Utedass/Tangentbordsknappar/electronics/design description/main.tex

\documentclass[11px]{specification}

% Input encoding and typographical rules for English language
\usepackage[utf8]{inputenc}
\usepackage[english]{babel}
\usepackage[english]{isodate}

\usepackage{float}

\usepackage{lipsum}
\usepackage{amsmath}

\usepackage{fontspec}
\usepackage{newunicodechar}
\newfontfamily\symbola{Symbola}
\newcommand{\downzigzagarrow}{\begingroup\symbola ↯\endgroup}
\newunicodechar{↯}{\downzigzagarrow}

% These define global texts that are used in headers and titles.
\title{BBB, Bestest Button Brick \\- Design Description}
\author{Jonatan Gezelius}
\date{Februari 2026}
\revision{Revision 0.1}
\companylogo{↯ Jegatron Electronics ↯}

\begin{document}

\maketitle

\section{Background}

\begin{multicols}{2}

\begin{colblock}
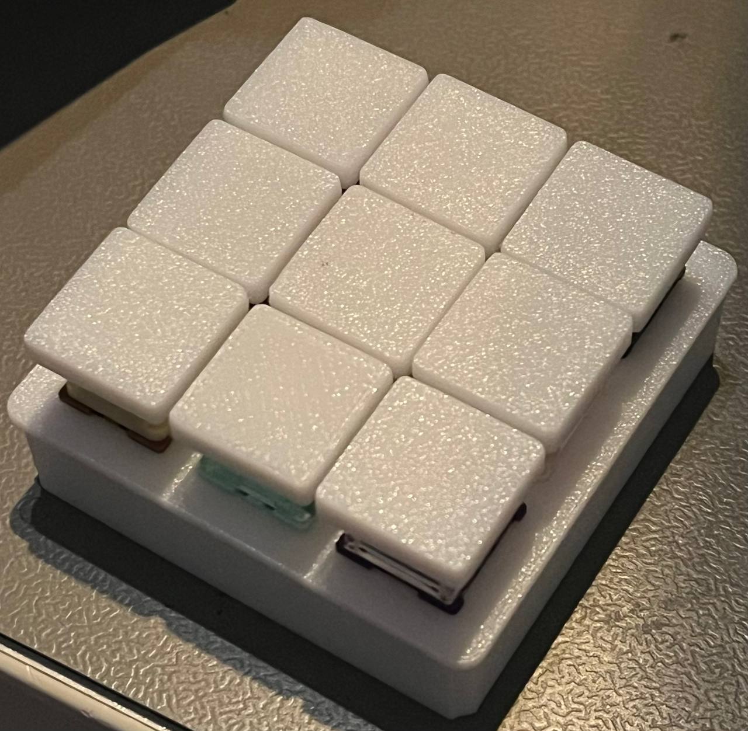
[picture p1: electronics/design description/figures/BBB-photo.jpg]
    
    \captionof{figure}{First iteration of BBB}
    \label{fig:systemDiagram}
\end{colblock}

The BBB is a multipurpose user programmable input device and also serves as an exercise product to hone my skills and try out different circuit solutions. Not all features and component make sense from a real product perspective, but serves as a learning experience.

It all started with the desire to have a more professional feel to my hobby and learning projects. So instead of using the classical tactile buttons forced down into a breadboard entangled in jumper wires, I bought some random mechanical keyboard switches and 3d-printed an enclosure for them. Then came the time to make the circuit board to empower this.

Feature creep. That is the spirit of this project. Because of personal projects I need the BBB need to be Zigbee enabled and preferably also wifi capable. Since I had already used the ESP32-C6 for such purposes I decided to use this.

\section{Features}

\begin{itemize}
    \item{Nine user programmable buttons}
    \item{ESP32-C6 - Zigbee, Wifi, BLE etc}
    \item{LiPo charger with Power Path}
    \item{USB-C sink IC}
    \item{LED lights}
\end{itemize}

\newpage
\tableofcontents

\newpage

\section{This document}
This document serves several purposes.
\begin{itemize}
    \item Description document when the design is done
    \item Working out the design
    \item Pointing out important design decisions
    \item Pointing out non-important design decisions
    \item Recognizing requirements
\end{itemize}

Design problems and decisions are written in a rounded rectangle.
\decision{How should I describe the design problems to the reader?}[By example!]

And recognized requirements are written in a sharp cornered rectangle.
\requirement*{The Design Description shall explain the usage of requirements in the document.}

These are summarized in the end of the document with the intent of being an input for external requirement management.

\newpage

\section{Hardware design}

The hardware architecture can be seen in figure \ref{fig:system-overview}. The design can definitely be made more simple and cheap, but that is not the purpose of this project. However, several of the parts can be skipped if not desired.

\subsection{Desired features}

\begin{itemize}
    \item{Zigbee}
    \item{Wifi}
    \item{Battery powered long life}
    \item{USB-C powered / charged}
    \item{LED lights}
\end{itemize}

\subsection{Optional Subsystems}

The following parts can be not-mounted or replaced with something else:
\begin{itemize}
    \item{USB-C Sink controller: Can be replaced by resistors.}
    \item{Fuel Gauge: Can be removed and the battery power can be bridged directly to the charger}
    \item{LiPo Charger + LiPo battery: Can be removed. System power directly bridged from VBUS.}
    \item{Boost regulator + LED Matrix: Can be skipped}
    \item{Miniature speaker: Can be skipped}
    \item{Flash: Can be avoided if using ESP32-C6FH4 or ESP32-C6FH8 instead}
\end{itemize}

\end{multicols}

\begin{figure}[H]
    \centering
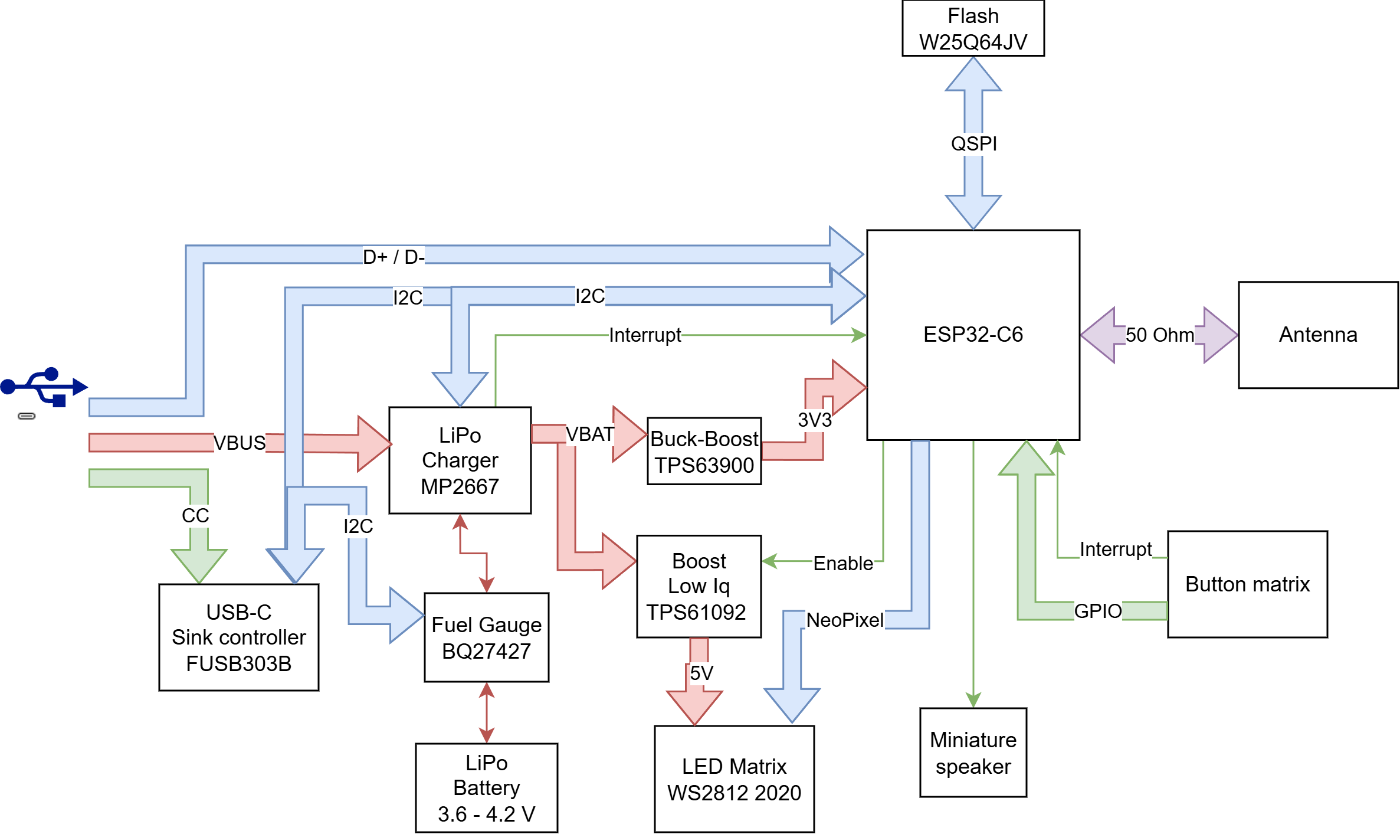
[picture p2: electronics/design description/figures/system-diagram.png]
    
    \caption{The hardware architecture of the BBB}
    \label{fig:system-overview}
\end{figure}

\newpage

\begin{multicols}{2}

\subsection{Power requirements}

Before any parts of the circuit can be properly designed, we need to determine the power and current requirements throughout the system.

The maximum peak current consumption of the ESP32-C6 is during WiFi transmission, which can be up to \qty{354}{\milli\ampere} at \qty{3.3}{\volt} which is about \qty{1.2}{\watt} \cite[66]{esp32-c6-datasheet}. The average power consumption will be much lower than this, but we need to design the power system to be able to handle this peak.

Each WS2812 2020 LED consumes about $3 \times \qty{12}{\milli\ampere} \approx \qty{40}{\milli\ampere}$ at full brightness. Which for the full matrix of 9 LEDs would be about \qty{360}{\milli\ampere}, which at \qty{5}{\volt} would be \qty{1.8}{\watt} \cite{ws2812-product-page}.

A speaker such as \url{https://www.electrokit.com/en/miniatyrhogtalare-8ohm-1w-11x15mm} driven with a MAX98357A class D amplifier can consume up to \qty{1}{\watt} at \qty{5}{\volt}, which is about \qty{200}{\milli\ampere}. It is possible to run it directly from $V_{SYS}$ from the battery but it cannot output the full power. And since the \qty{5}{\volt} boost regulator will be able to handle \qty{1.5}{\ampere} when fed with \qty{3.6}{\volt} from the battery I decide to put it on the \qty{5}{\volt} rail.

\end{multicols}

\begin{table}[H]
    \centering
    \begin{tabular}{|l|r|r|r|}
        \hline
        \textbf{Subsystem}     & \textbf{Voltage} & \textbf{Peak Current}    & \textbf{Peak Power}       \\
        \hline
        ESP32-C6 (WiFi TX)     & \qty{3.3}{\volt} & \qty{354}{\milli\ampere} & \qty{1.2}{\watt}          \\
        LED Matrix (9x WS2812) & \qty{5}{\volt}   & \qty{360}{\milli\ampere} & \qty{1.8}{\watt}          \\
        Speaker (MAX98357A)    & \qty{5}{\volt}   & \qty{200}{\milli\ampere} & \qty{1.0}{\watt}          \\
        \hline
        \textbf{Total}         &                  &                          & \textbf{\qty{4.0}{\watt}} \\
        \hline
    \end{tabular}
    \caption{Peak current and power consumption summary}
    \label{tab:power-summary}
\end{table}

\begin{multicols}{2}

A \qty{500}{\mAh} battery might fit into the enclosure, and with an allowed discharge current of \qty{2}{C} it will only be able to provide max \qty{3.6}{\watt}. So not all things will be able to run at full power at the same time, but that is not a requirement for this project.

\subsection{Battery}
The thickness of the current compartment left for a battery is at most \qty{5}{\milli\meter}. The area depends on wether the PCB will be fastened by screws or not. If screws are used, then only a maximum of \qtyproduct{35 x 35}{\milli\meter} is available for a battery.

\decision{What battery to use?}[Go with the \qty{400}{mAh} battery from electrokit for now: \url{https://www.electrokit.com/batteri-lipo-3.7v-400mah}]

I should probably redesign the enclosure to allow for a bigger battery. It might be difficult to fit this with connectors and all.

\begin{table}[H]
    \centering
    \begin{tabular}{|l|r|}
        \hline
        \textbf{Property}            & \textbf{Value}           \\
        \hline
        Recommended Charging Current & \qty{80}{\milli\ampere}  \\
        Maximum Charging Current     & \qty{400}{\milli\ampere} \\
        Maximum Discharge Current    & \qty{800}{\milli\ampere} \\
        \hline
    \end{tabular}
    \caption{Battery specifications}
    \label{tab:battery-specs}
\end{table}

\subsection{Charger Circuit}
BQ25601

Other candidates were MP2667, which has better quiescent current but no OTG and BQ25895 but it has D+/D- pins which I require for other purposes.
\requirement{The battery charger shall be optional}

\decision{Should I make use of the shipping mode for the battery?}

\subsubsection{Important features}
As soon as the input voltage or battery voltage is high enough, the device will power up. At power up, the Input Current Limit is updated to reflect the \sig{PSEL} pin (\qty{500}{\milli\ampere} or \qty{2.4}{\ampere}). When this is done, the system output \sig{} is soft-started and the switch converter for the battery charging is enabled.

If nothing is done, the device will automatically enter Default Mode which means it will autonomously act as a battery charger and charge the battery. To exit this mode, the host must write a 1 to the \sig{WD\_RST} but. Then the device enters Host Mode until the watchdog timer times out and \sig{WATCHDOG\_FAULT} is set and the device returns to Default Mode.

The default fast charging current \sig{ICHG} is \qty{2040}{\milli\ampere} which is way too much for the chosen battery. Setting the Input Current Limit \sig{IINDPM} using the pin \sig{PSEL} high limits this to \qty{500}{\milli\ampere}. This might still be too much since the proposed battery allows a maximum charging current of \qty{400}{\milli\ampere} and the step-down converter will allow a higher charging current than input current.

\decision{Will the charger have to be disabled somehow at startup, and later enabled by the host, to prevent over current to the battery? Can be handled via the $\bar{CE}$ pin.}[Yes, the current is way too large for this battery, the $\bar{CE}$ pin must be pulled up to prevent automatic charging.]

\decision{Will some sort of startup delay or under-voltage-lock-out be needed for the subsequent circuits so that the soft-start can work properly?}

The device can operate in boost-mode to convert the battery voltage to \qty{5}{\volt} and max \qty{1.2}{\ampere} for OTG use. This is controlled via I2C.

\requirement{There shall be a green LED controlled by the Power Good signal}

\requirement{There shall be a red LED controlled by the  signal}

\end{multicols}

\subsubsection{Typical application}
The typical application is shown in \ref{fig:bq25601-typical-application}.

There are three explained design procedures for determining the Inductor, the input Capacitor and the output Capacitor respectively.

$I_{SAT} \ge I_{CHG} + \frac{1}{2} I_{RIPPLE}$

$D = \frac{V_{BAT}}{V_{VBUS}}$

\begin{equation}
    I_{RIPPLE} = \frac{V_{IN} \times D \times (1-D)}{f_s \times L} \iff L = \frac{V_{IN} \times D \times (1-D)}{f_S \times I_{RIPPLE}}
\end{equation}

The inductors saturation current must be larger than the maximum charge current plus half the ripple current. The larger the inductance, the lower the ripple current. All of the parameters except the inductance and ripple current is known. According to you neighbouring LLM the ripple current should be \qtyrange{25}{30}{\percent} of the maximum load current, so about \qty{100}{\milli\ampere}. Lets see where that lands us.

\begin{equation}
    D = \qty{3.2}{\volt} / \qty{5}{\volt} = 0.64
\end{equation}
\begin{equation}
    L = \frac{\qty{5}{\volt} \times 0.64 \times (1 - 0.64)}{\qty{1.5}{\mega\hertz} \times \qty{0.1}{\ampere}} =
    \frac{\qty{1.152}{\volt}}{\qty{0.15}{\mega\hertz\ampere}} = \qty{7.68}{\micro\henry} \approx
    \qty{6.8}{\micro\henry}
\end{equation}

The saturation current must be greater than $\qty{400}{\milli\ampere} + \qty{50}{\milli\ampere} = \qty{450}{\milli\ampere}$. The self resonance should be greater than $10 \times f_S$ the switching frequency, so more than \qty{15}{\mega\hertz}. For example the WIP322512A-6R8MLDG from INPAQ Technology Co., Ltd that comes in a standard 1210 package and has many second source alternatives.

The input capacitor should be able take care of the ripple current. Suggestions make me target two or three \qty{10}{\micro\farad} capacitors in 0805 package.
$I_{CIN}=I_{CHG} \times \sqrt{D \times (1 - D)}$

$I_{COUT} = \frac{I_{RIPPLE}}{2 \times \sqrt{3}} \approx 0.29 \times I_{RIPPLE}$

$\Delta V_O = \frac{V_{OUT}}{8LCfs^2} \left( 1 - \frac{V_{OUT}}{V_{IN}} \right)$

\begin{figure}
    \centering
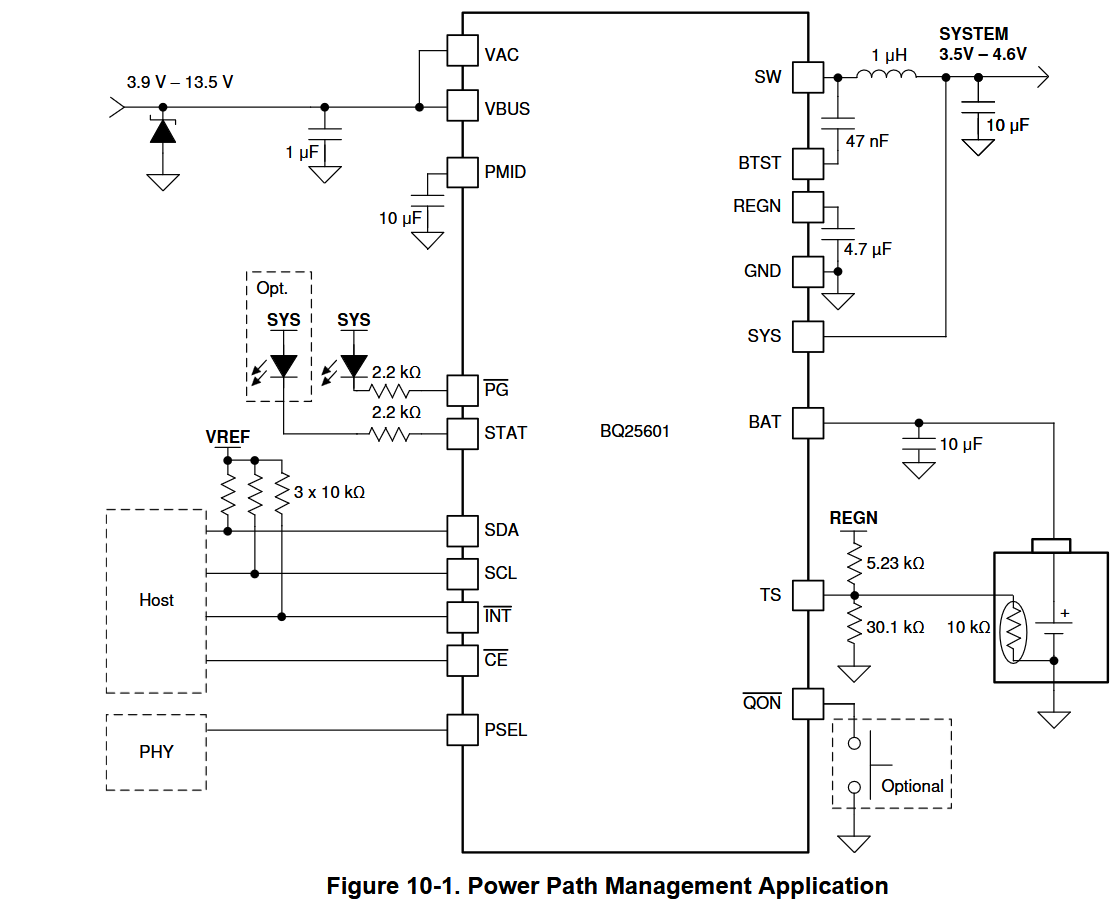
[picture p3: electronics/design description/figures/bq25601-typical-application.png]
    
    \caption{BQ25601 typical application, section 10.2 in the datasheet. \cite{bq25601-datasheet}}
    \label{fig:bq25601-typical-application}
\end{figure}

\begin{multicols}{2}

\subsection{USB-C Sink Controller}
FUSB303B

\subsection{Fuel Gauge}
BQ27441-G1

Another option might have been BQ27427, but it is bga.

\subsection{3V3 Buck-Boost Regulator}
TPS63900

\subsection{5V Boost Regulator}
TPS61092

\subsection{LED}
WS2812

\subsection{Speaker amplifier}
MAX98357A

\subsection{MCU}
ESP32-C6

\subsubsection{Flash}
W25Q64JV

The QSPI pin mapping to the ESP32 is described in the datasheet \cite[32]{esp32-c6-datasheet}.

Datasheet \cite{w25q64jv-datasheet}

\subsubsection{Antenna}
PCB Antenna, see \autoref{sec:PCB-Antenna}.
\subsection{Protection circuits}
\subsubsection{ESD}
\requirement{The USB-C port shall have ESD protection}
\requirement{The battery port shall have ESD protection unless it affects leakage too much.}
\subsubsection{Reverse polarity}
\requirement{Ensure keyed connector for battery.}
\subsubsection{Over current}
\requirement{There shall be some sort of fuse for the battery.}

\subsection{Layout considerations}
In the following sections most layout related decisions will be clarified.
\subsubsection{Board outline}
\subsubsection{Mounting features}
\subsubsection{Keep outs}
\subsubsection{PCB Antenna}
\label{sec:PCB-Antenna}
Inverted-F antenna, perhaps according to \url{https://www.ti.com/lit/an/swru120d/swru120d.pdf?ts=1775731789186}.
\subsubsection{Connectors}
\subsubsection{Switches}
\subsubsection{LEDs}
\subsubsection{Test points}
\subsubsection{Jumpers and options}
\begin{itemize}
    \item Option of having no charger circuitry
    \item Option of having no USB-C Sink controller
    \item Option of having no fuel gauge
    \item Optional jumper inline with power for measuring quiescent currents
\end{itemize}
\subsubsection{Overlay information}

\end{multicols}

\printindex[req]

\printbibliography[heading=bibintoc]

\end{document}
