Utedass/Tangentbordsknappar/3d/KeyBoxLidBottom.FCStd

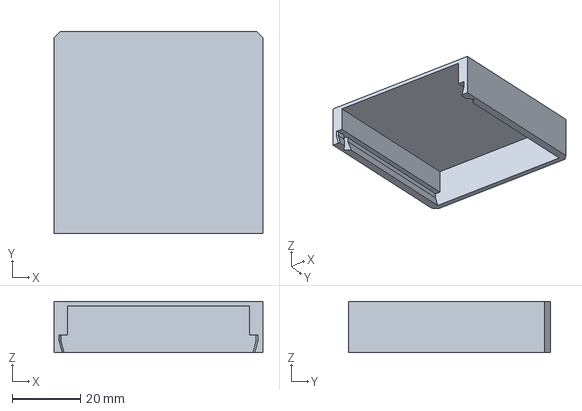
[picture p4: CAD file, 2026-01-27]
3d/KeyBoxLidBottom.FCStd
61.1 x 59.2 x 15.0 mm
