Utedass/Tangentbordsknappar/electronics/mainboard/GenericPCB-Body.dxf

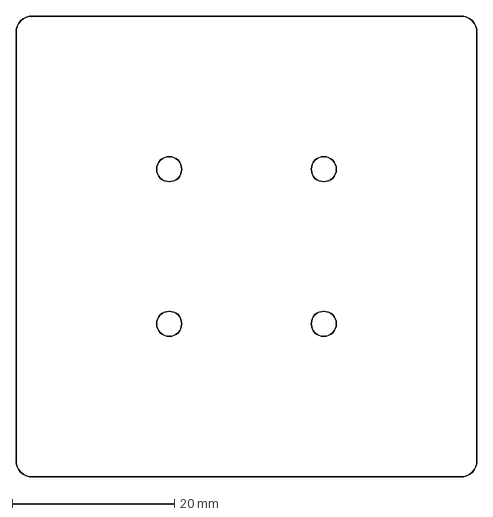
[picture p5: CAD file, 2026-01-27]
electronics/mainboard/GenericPCB-Body.dxf
56.8 x 56.8 mm
