Utedass/Tangentbordsknappar/3d/Flatcap.FCStd

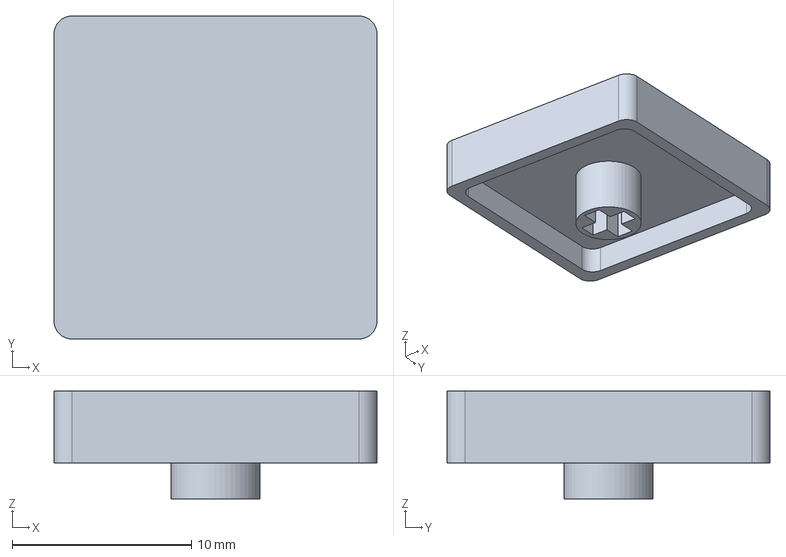
[picture p6: CAD file, 2026-01-27]
3d/Flatcap.FCStd
18.0 x 18.0 x 6.00 mm
