Utedass/Tangentbordsknappar/3d/GenericPCB.FCStd

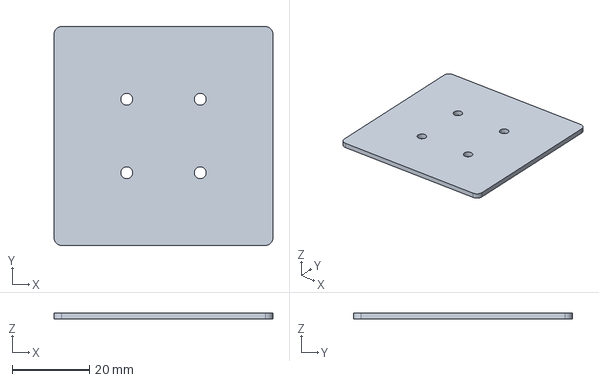
[picture p7: CAD file, 2026-01-27]
3d/GenericPCB.FCStd
56.8 x 56.8 x 1.60 mm
