Utedass/Tangentbordsknappar/3d/KeyBox.FCStd

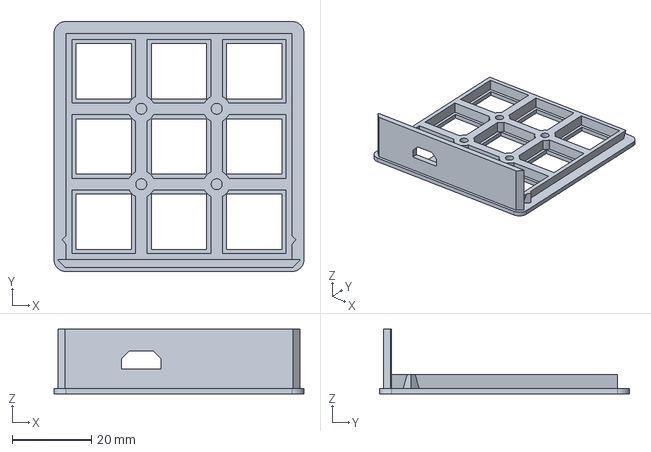
[picture p8: CAD file, 2026-01-27]
3d/KeyBox.FCStd
63.2 x 63.1 x 16.4 mm
