Utedass/Tangentbordsknappar/3d/Keyswitch.FCStd

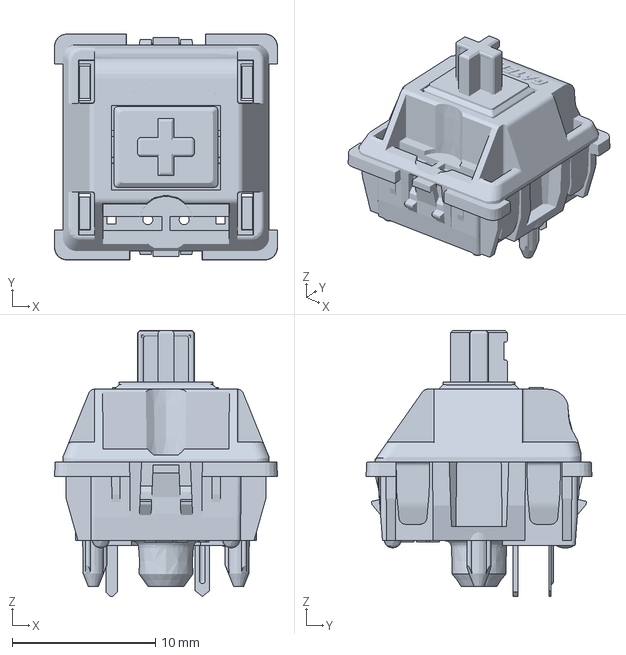
[picture p9: CAD file, 2026-01-24]
3d/Keyswitch.FCStd
15.6 x 15.8 x 18.6 mm
