Utedass/Tangentbordsknappar/3d/Keyframe.FCStd

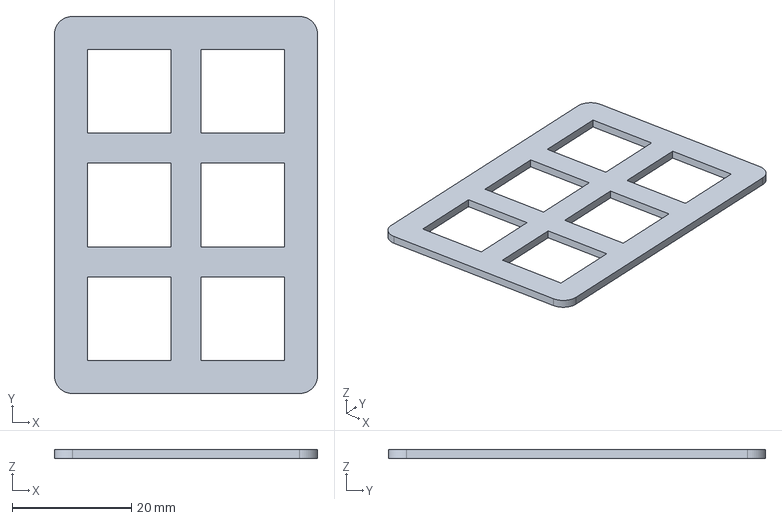
[picture p10: CAD file, 2026-01-21]
3d/Keyframe.FCStd
44.1 x 63.2 x 1.50 mm
