Utedass/Tangentbordsknappar/(list of files, cad)

Other CAD files:
3d/Assembly.FCStd
3d/keyswitch.3mf
