Utedass/Tangentbordsknappar/electronics/mainboard/mainboard.kicad_pcb

## KiCad design electronics/mainboard/mainboard.kicad_pcb (2026-02-01)

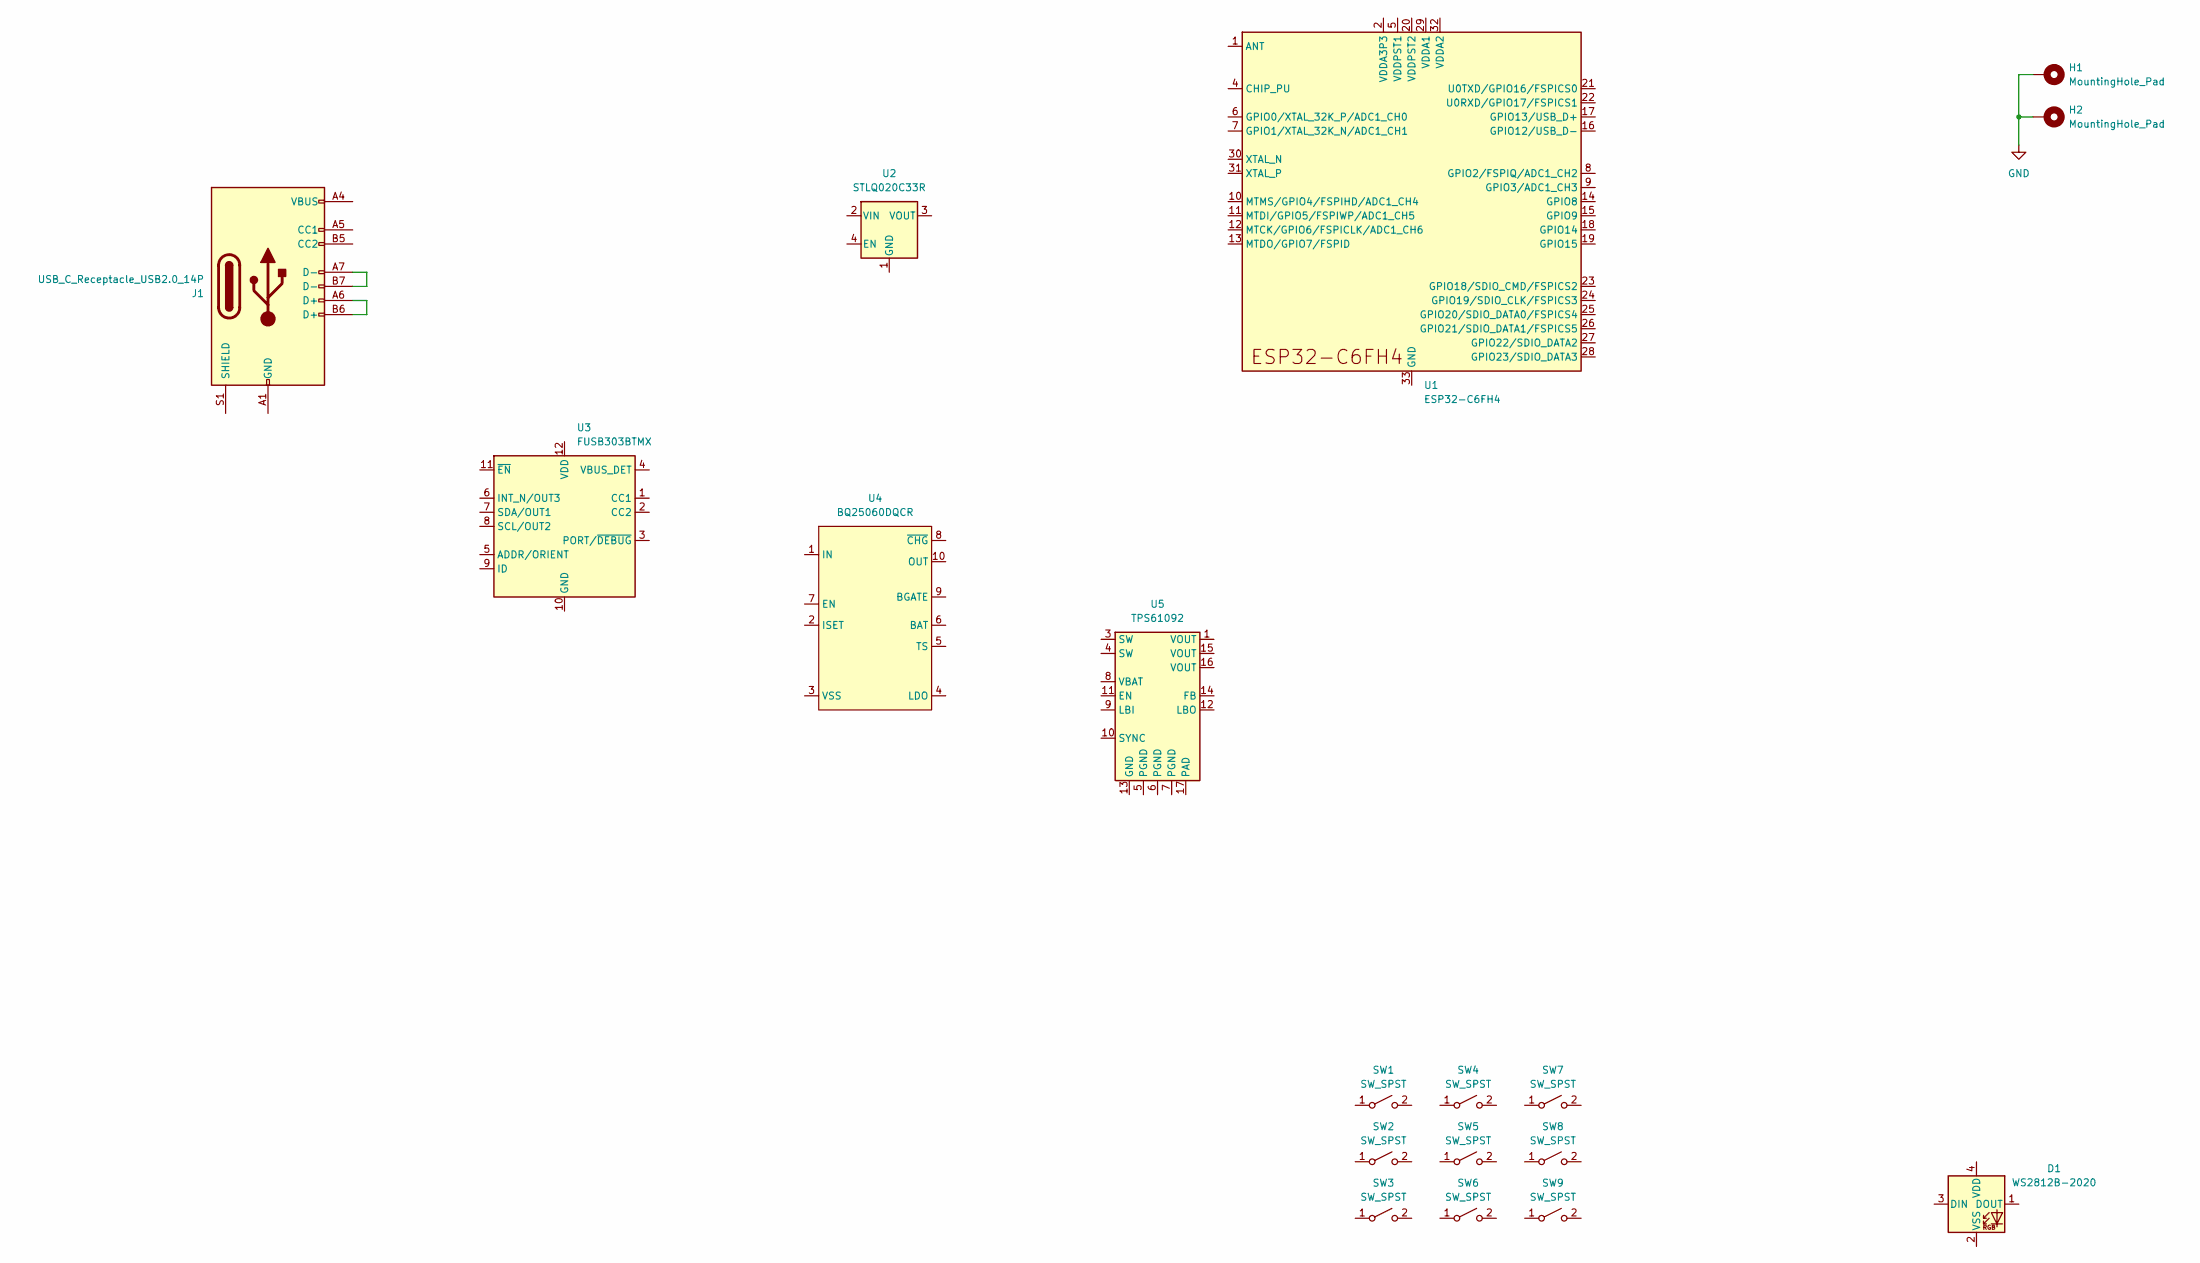
[picture p11: schematic mainboard.kicad_sch]

Parts:
D1: WS2812B-2020; LED_WS2812B-2020_PLCC4_2.0x2.0mm
H1, H2: MountingHole_Pad; MountingHole_3.2mm_M3_Pad_Via
J1: USB_C_Receptacle_USB2.0_14P; USB_C_Receptacle_GCT_USB4085
SW1, SW2, SW3, SW4, SW5, SW6, SW7, SW8, SW9: SW_SPST; SW_Cherry_MX_PCB
U1: ESP32-C6FH4; QFN-32-1EP_5x5mm_P0.5mm_EP3.6x3.6mm
U2: STLQ020C33R; SOT-23-5
U3: FUSB303BTMX; Texas_X2QFN-12_1.6x1.6mm_P0.4mm
U4: BQ25060DQCR; WSON-10-1EP_2x3mm_P0.5mm_EP0.84x2.4mm
U5: TPS61092; Texas_RSA_VQFN-16-1EP_4x4mm_P0.65mm_EP2.7x2.7mm_ThermalVias

Connections:
GND: H1.1, H2.1
unnamed: J1.A6 (D+), J1.B6 (D+)
unnamed: J1.A7 (D-), J1.B7 (D-)
unnamed: J1.A1 (GND), J1.A12 (GND), J1.B1 (GND), J1.B12 (GND)
unnamed: J1.A4 (VBUS), J1.A9 (VBUS), J1.B4 (VBUS), J1.B9 (VBUS)
unnamed: U1.2 (VDDA3P3), U1.3 (VDDA3P3)

Board: 2 copper layers, 18 parts (6 on the bottom side), 6 nets, no tracks yet.
