Utedass/Tangentbordsknappar/(commit log)

2026-01-22 Extend fitting-sleeve by .2
    [Flatcap.FCStd]
2026-01-22 Add beginning of a keybox
    [KeyBox.FCStd]
2026-01-23 Make fitting sleve longer
    [Flatcap.FCStd]
2026-01-24 Add screw holes in intersections
    [KeyBox.FCStd]
2026-01-24 Add keyswitch model. Add dovetail to plate. Create assembly.
    [Assembly.FCStd, GenericPCB.FCStd, KeyBox.FCStd, Keyswitch.FCStd, keyswitch.3mf]
2026-01-24 Add side to plate
    [Assembly.FCStd, KeyBox.FCStd, KeyBoxLidBottom.FCStd]
2026-01-25 Don't remmember...
    [Assembly.FCStd, KeyBoxLidBottom.FCStd]
2026-01-25 Update file structure
    [Assembly.FCStd, Flatcap.FCStd, GenericPCB.FCStd, KeyBox.FCStd, KeyBoxLidBottom.FCStd, Keyframe.FCStd, Keyswitch.FCStd, keyswitch.3mf]
2026-01-25 Close the box
    [Assembly.FCStd, KeyBox.FCStd, KeyBoxLidBottom.FCStd]
2026-01-25 Add USB hole. Start kicad project.
    [Assembly.FCStd, KeyBox.FCStd, KeyBoxLidBottom.FCStd, mainboard.kicad_pcb, mainboard.kicad_sch]
2026-01-26 Add tiny tolerance to bottom-lid for PCB thickness
    [KeyBoxLidBottom.FCStd]
2026-01-26 Add more tolerance to dovetail joint.
    [KeyBoxLidBottom.FCStd]
2026-01-26 Remove tolerances, good fit without. Add locking notch.
    [Assembly.FCStd, KeyBox.FCStd, KeyBoxLidBottom.FCStd]
2026-01-27 Add gitattributes. Layout position of switches and board outline
    [Assembly.FCStd, Flatcap.FCStd, GenericPCB-Body.dxf, GenericPCB.FCStd, KeyBox.FCStd, KeyBoxLidBottom.FCStd, mainboard.kicad_pcb]
2026-01-31 Add system diagram. Add project symbol library. Add fundamental components to schematic.
    [mainboard.kicad_pcb, mainboard.kicad_sch]
2026-02-01 Fix boardcut.
    [mainboard.kicad_pcb]
2026-02-01 Ignore lock file. Change switch footprint to exclude spacing. Change hole footprint to include pad.
    [mainboard.kicad_pcb, mainboard.kicad_sch]
2026-04-07 Add frame to design problems
2026-04-09 Fill out info regarding charger.
2026-04-10 Fill out the charger chapter more.
